das-labor/badge-2021/software/README.md

# Software

The emulator uses pygame to emulate a display
using the micropython display api for
[FrameBuffer](http://docs.micropython.org/en/latest/library/framebuf.html)
and [SSD1306](https://github.com/micropython/micropython/blob/master/drivers/display/ssd1306.py).
