das-labor/badge-2021/img/labortage2022.png

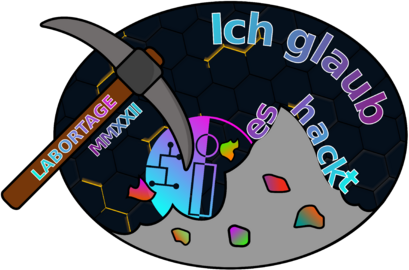
img/labortage2022.png
