das-labor/badge-2021/img/labortage2023.bmp

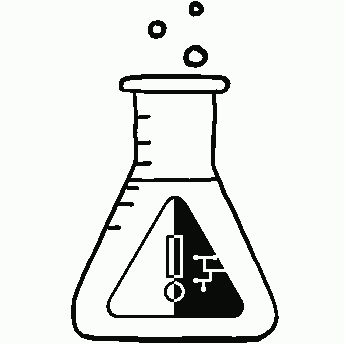
img/labortage2023.bmp
