das-labor/badge-2021/hw/Labortage2021b.dxf

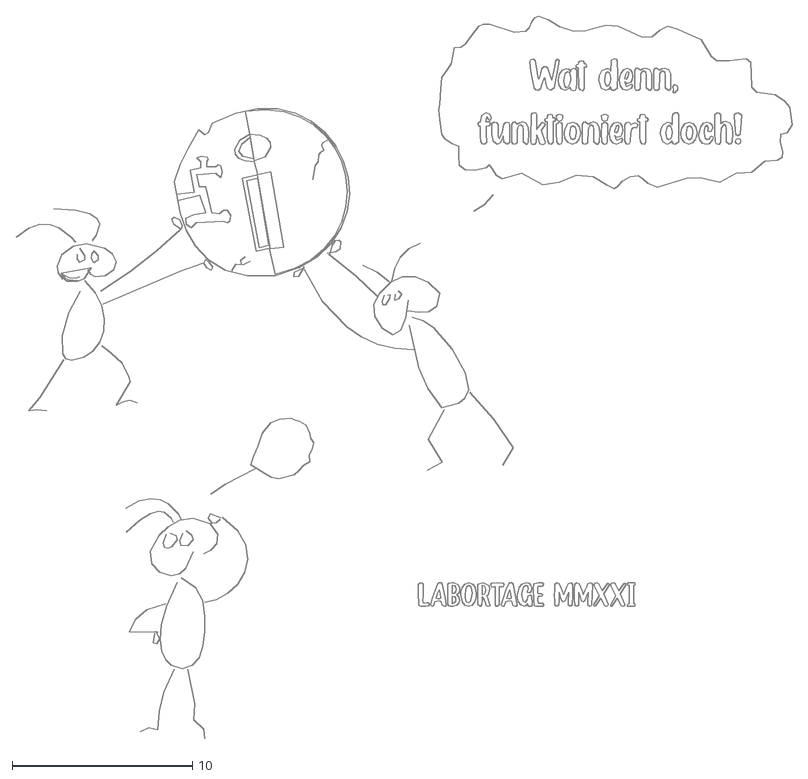
[picture p14: CAD file, 2021-07-12]
hw/Labortage2021b.dxf
43.1 x 40.1
