das-labor/badge-2021/hw/esp32mini.dxf

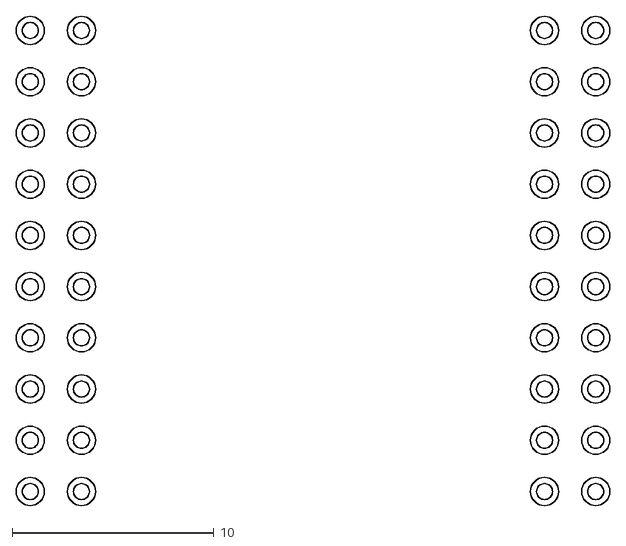
[picture p15: CAD file, 2021-06-03]
hw/esp32mini.dxf
29.4 x 24.3
