das-labor/badge-2021/(threads)

Thread 4 (2021-04-06):

Artwork

e7p, 2021-04-06:
Every great badge needs some awesome artwork. I'd really like to volunteer in taking an art draft and putting it into the PCB-shape. Thus, I could also do all the routing stuff basically. Concluding, push here in case any great PCB-art ideas arise and / or the schematic is done. :)

E.g.: What about the style of the logo of @das-labor?

orangecms, 2021-05-16:
We'd love to have the event artwork \o/
Do you have already for vectorization?

e7p, 2021-05-16:
So basically it is not clear when / who makes the event artwork now. I also offered help in vectorization there, however the last information was that they would do it themselves. I'll ask again about the current state of the official event logo now.

orangecms, 2021-05-22:
Please have a look at the sketch in the README:
https://github.com/das-labor/badge-2021#sketch

That is quite close to the shape of a famous handheld pocket gaming device. :-)

We just made some progress with the schematics yesterday and withe the prototype.
Check this out: https://twitter.com/OrangeCMS/status/1395852445847334912?s=19 :-)

e7p, 2021-05-25:
Yes, I already saw the general sketch, not yielding much real artwork ideas though. But no problems. Which famous pocket gaming device? I cannot recall any Gameboy having two joysticks on the bottom...

orangecms, 2021-05-25:
> Yes, I already saw the general sketch, not yielding much real artwork ideas though. But no problems. Which famous pocket gaming device? I cannot recall any Gameboy having two joysticks on the bottom...

Sorry, I just meant the board dimensions. They are close to a GameBoy Pocket. Can you help me understand what is missing for you? Maybe elaborate on "general PCB shape", I thought you meant the dimensions and basic outline, like what the sketch is showing. 🤔

e7p, 2021-05-25:
Well, the most important detail I somehow missed was, that the sketch in the README already showed the desired form factor. Otherwise I would have guessed that the badge might be also in the format similar to the event logo. Badges like these do exist. However, if only a simple form is wished, no problem.

Other things that are missing for now:
* final schematic
* vectorized event logo (still no response... I'll ask again)

So, not too much missing until we're getting more creative :eggplant:

e7p, 2021-06-11:
Making progress with the vectorization of the event logo / design. Will look great on the badge, promise :smile:

e7p, 2021-08-18:
Umm, when again will the final PCBs be ordered? I think it was end of August. I might find some time for integrating the logo next week, hope this is sufficient.

orangecms, 2021-08-18:
If you look at the current board, you should see the logo already baked in; @arnobert just did that before ordering rev 1. You should find some rev 1 boards floating around, they've arrived already. :)

And sorry, I totally forget to write that here... could you maybe check if there's any adjustments you'd like to do? 🙏

orangecms, 2021-09-25:
closing now since we made the final order and the job is done 🥳

Closed 2021-09-25.

Thread 10 (2021-11-07):

bootup on MH-ET LIVE ESP32 board

orangecms, 2021-11-07:
While those boards only cost half of the price of a board with the same pinout fron AZ Delivery, there are some nuances to the boot process, namely with the usage of GPIO0, as it turns out:
 https://www.instructables.com/Flashing-Micropython-to-ESP32-MinikitMH-ET-LIVE/

We should be able to fix this easily. Currently, we use GPIO0 for the left button.

sellerie98, 2022-01-08:
Where is even GPIO0? I cannot find any mention of it neither on the silk screen nor in the pinout picture from the readme.
The silk screen has two pins marked as `NC`. Is it one of them?

Thread 9 (2021-11-07):

notes on GPIO usage

orangecms, 2021-11-07:
https://randomnerdtutorials.com/esp32-pinout-reference-gpios/ has a nice table on pin usage. We had some issues during board development, where I messed up pin assignments. We should write those down as errata and explain more on the IO pins.

Thread 13 (2021-11-18):

document BOM creation

orangecms, 2021-11-18:
Hard to find in the KiCAD menu if you're new to it; see https://forum.kicad.info/t/how-to-create-a-bill-of-materials-bom/12346
