das-labor/badge-2021/hw/schematics.pdf

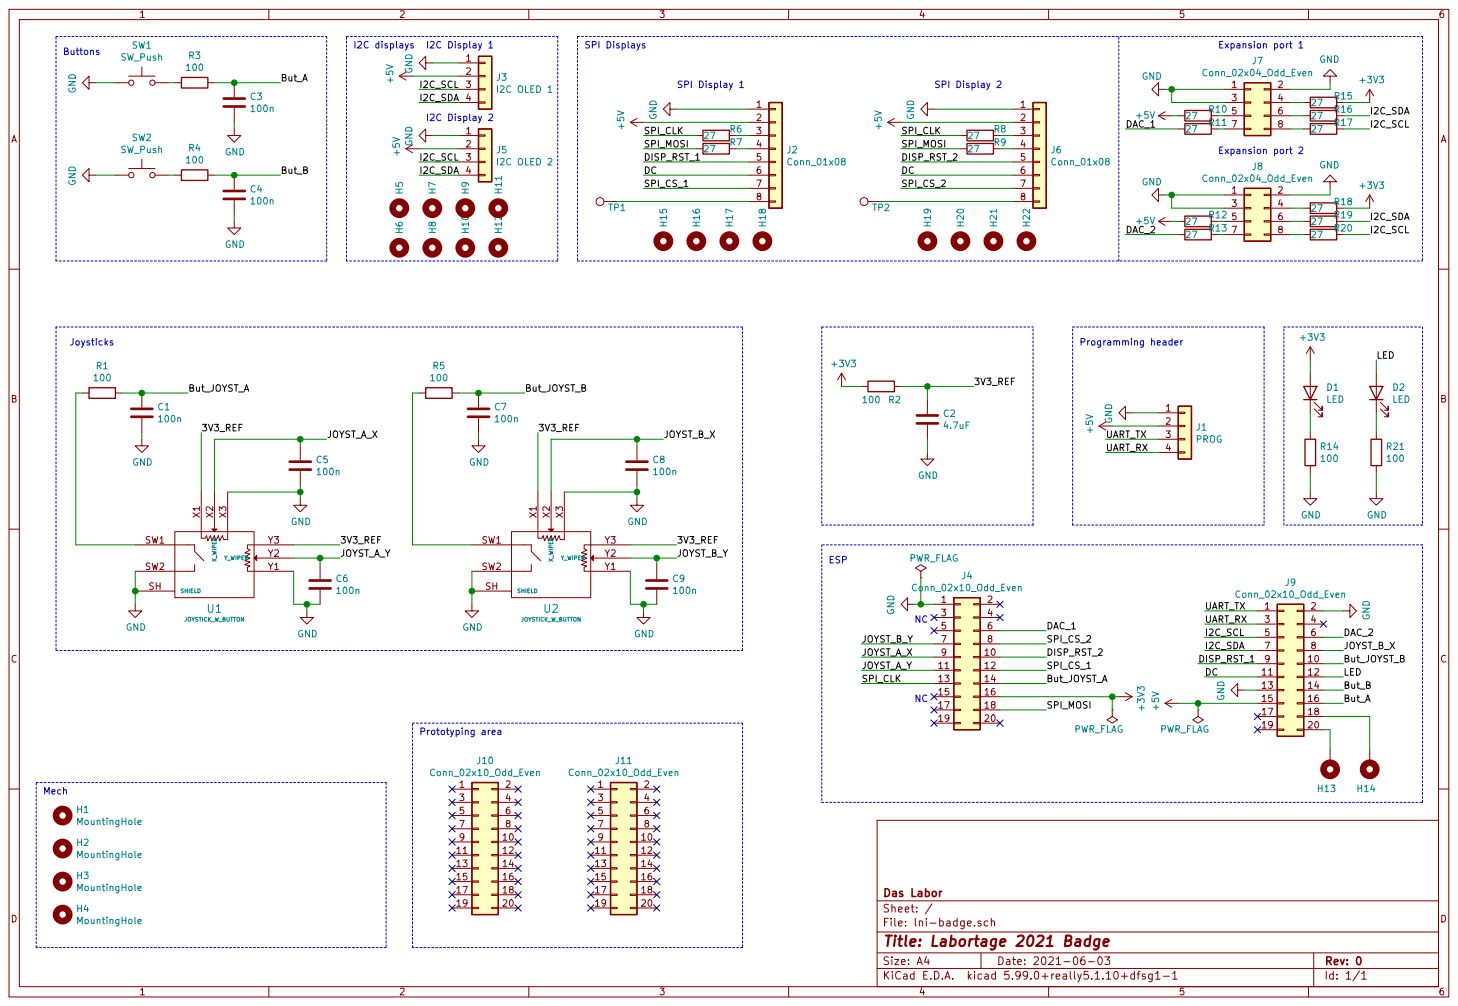
[picture p16: page 1]

Id: 1/1 Title: Labortage 2021 Badge
