das-labor/badge-2021/(commit log)

2021-03-21 add reference to original schematics
2021-03-28 Fix typo schEmatics
2021-04-01 Added display connectors, clean up
    [lni-badge.sch]
2021-05-14 Added mechanics
    [lni-badge.sch]
2021-05-21 Moved KiCad project into subfolder
    [lni-badge.kicad_pcb, lni-badge.sch]
2021-05-21 spi_rects: use IO19 for second reset so 26 is free for DAC use
    [spi_rects.py]
2021-05-21 Improved schematic
    [lni-badge.sch]
2021-05-21 Clean up
    [lni-badge.kicad_pcb, lni-badge.sch]
2021-05-21 Removed old KiCad project
    [lni-badge.kicad_pcb, lni-badge.sch]
2021-05-30 Add information on VDET/ADC and josticks
2021-06-03 Finalize schematic
    [lni-badge.sch]
2021-06-03 Finished PCB
    [esp32mini.dxf, lni-badge.sch]
2021-06-03 Add ADC test code
    This disables the I2C display demo for now. It's all just demos after all. ;)
2021-06-03 Calibrate joystick demo ADCs - Daniel only ;)
2021-06-03 Add reference to ESP32-WROOM-32 data sheet
2021-06-03 README: replace sketch with PCB 3D model export
2021-06-13 README: add note on buttons
2021-06-16 README: elaborate on different button sizes
2021-06-18 README: add PCB size measurements
2021-06-28 Added github link onto board
    [lni-badge.kicad_pcb]
2021-07-02 README: elaborate on project idea and link schematics
2021-07-03 spi_rects.py: fix up joystick descriptions
    [spi_rects.py]
2021-07-03 spi_rects.py: fix up the fixup
    Sorry, I cannot tell v and h apart on a Saturday morning 🙃
    [spi_rects.py]
2021-07-03 Fixed 3V3 ref resistor
    [lni-badge.sch]
2021-07-03 Changed prototyping area and added dot/dash
    [lni-badge.kicad_pcb, lni-badge.sch]
2021-07-08 Added mounting holes for displays
    [lni-badge-B_Cu.gbr, lni-badge-B_Mask.gbr, lni-badge-B_Paste.gbr, lni-badge-B_SilkS.gbr, lni-badge-Edge_Cuts.gbr, lni-badge-F_Cu.gbr, lni-badge-F_Mask.gbr, lni-badge-F_Paste.gbr]
2021-07-08 Updated expansion pinout and inc. button size to 12mm
    [lni-badge.kicad_pcb, lni-badge.sch]
2021-07-08 sw-demo/i2c_scroll: strip down and reintegrate
2021-07-10 hw/board: label the expansion headers
    [lni-badge.kicad_pcb]
2021-07-12 Added drawings
    [Labortage2021b.dxf, lni-badge.kicad_pcb]
2021-07-12 Fixed joystick footprints
    [lni-badge.kicad_pcb]
2021-07-13 Export REV 1
    [lni-badge-B_Cu.gbr, lni-badge-B_Mask.gbr, lni-badge-B_Paste.gbr, lni-badge-B_SilkS.gbr, lni-badge-Edge_Cuts.gbr, lni-badge-F_Cu.gbr, lni-badge-F_Mask.gbr, lni-badge-F_Paste.gbr]
2021-07-13 Update REV 1
    [lni-badge-B_Cu.gbr, lni-badge-B_Mask.gbr, lni-badge-B_Paste.gbr, lni-badge-B_SilkS.gbr, lni-badge-Edge_Cuts.gbr, lni-badge-F_Cu.gbr, lni-badge-F_Mask.gbr, lni-badge-F_Paste.gbr]
2021-07-13 Update PCB 3D model export
2021-08-03 Updated C9 position
    [lni-badge.kicad_pcb]
2021-08-03 Re-filled areas
    [lni-badge.kicad_pcb]
2021-08-27 Fixed DRC
    [lni-badge-Eco2_User.dxf, lni-badge.kicad_pcb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]
2021-08-27 add demo with ST7789 240x240 display, LED and buttons
2021-08-29 REV2 ready for production
    [lni-badge.kicad_pcb, lni-badge.sch]
2021-08-29 Moved REV text to copper
    [lni-badge-Eco2_User.dxf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]
2021-08-29 Export Gerber
    [lni-badge-B_Cu.gbr, lni-badge-B_Mask.gbr, lni-badge-B_Paste.gbr, lni-badge-B_SilkS.gbr, lni-badge-Edge_Cuts.gbr, lni-badge-F_Cu.gbr, lni-badge-F_Mask.gbr, lni-badge-F_Paste.gbr]
2021-09-22 README: add note on MH-ET LIVE ESP32 MiniKit board
2021-09-22 sw-demo/spi_rects: add buttons and I2C display
2021-09-22 update schematics
2021-09-27 REV3 - fixed button A, cleaned up board
    [lni-badge.kicad_pcb, lni-badge.sch]
2021-10-08 sw-demo/spi_rects: reenable button A on GPIO0
2021-10-08 sw-demo/spi_rects: only toggle LED on button A
2021-10-15 boot.py: remove i2c_scroll
    This is already in spi_rects and will all be reorganized.
2021-11-14 add image of assembled badge
2021-12-12 README: add link to NodeMCU ESP32 build instructions
2022-04-13 README: Add links to more ESP32 documents
2022-04-24 sync schematics
2022-04-24 sw-demo: add joystick buttons
2022-04-24 Replace flash and erase scripts with Makefile
    This allows for passing parameters to the commands and do all in one go.
    One common issue is that some distros call the binary in PATH simply `esptool`,
    while upstream wants to call it `esptool.py`. That can be confusing.
    Another culprit is the port to use. Depending on the board, it can be a ttyUSB
    or a ttyACM device.
    Example:
    ```
    make ESPTOOL=esptool.py FW=firmware.bin erase flash
    ```
    This will erase the flash and then write `firmware.bin` to it, using `esptool.py`.
2022-11-05 README: add notes on boot option and button
2023-04-04 Presentation (#16)
    add workshop presentation
    may contain traces of Rust UwU 🦀
    with local copies of images from Wikipedia
2023-12-27 fix typo regarding joystick usage
    [spi_rects.py]
